sokolovmy/HLC/README.md

# HLC Home Light Controller 

v0.4 HW & FW
