sokolovmy/HLC/HW/COMMON_BOM.xlsx

Sheet: main_board
Reference | Quantity | Value | Footprint | LCSC Part | P/N | Arrow Part Number | %
BT1 | 1 | 3v | Battery:BatteryHolder_Keystone_106_1x20mm
C1 | 1 | 100pf | Capacitor_SMD:C_0402_1005Metric | C696853
C10 C11 C12 C13 C14 C15 C16 C17 C21 | 9 | 0,1uF | Capacitor_SMD:C_0402_1005Metric | C83056
C18 | 1 | 22nf | Capacitor_SMD:C_0402_1005Metric | C466237
C19 | 1 | 10uF | Capacitor_SMD:C_0805_2012Metric | C337995
C2 C3 C4 C5 C6 C23 C24 C25 C26 C27 C28 C29 C30 C31 C32 C33 C34 C35 C36 C37 C38 C39 C40 C41 C42 C43 C44 C45 C46 C47 C48 C49 C50 C51 C52 C53 C54 C55 | 38 | 100nf | Capacitor_SMD:C_0402_1005Metric | C83056
C20 | 1 | 22uF/25v | Capacitor_SMD:C_0805_2012Metric_Pad1.18x1.45mm_HandSolder | C45783
C22 | 1 | 22uF | Capacitor_SMD:C_0805_2012Metric | C45783
C8 C9 | 2 | 1uF | Capacitor_SMD:C_0603_1608Metric | C1592
D24 | 1 | 10V/0.5W | Diode_SMD:D_MiniMELF | C707201
D4 D5 D8 D9 D10 D11 D12 D13 D14 D15 D16 D17 D18 D19 D20 D21 D22 D23 | 18 | PESD3v3S2UT | Package_TO_SOT_SMD:SOT-23 | C84276
D6 D7 D25 | 3 | SS14 | Diode_SMD:D_SMA_Handsoldering | C509048
F1 | 1 | 0.4A | Fuse:Fuse_1812_4532Metric_Pad1.30x3.40mm_HandSolder | C369179
J1 | 1 | Program | holse:Program_Crossboard
J11 | 1 | cross | holse:Crossboard
J2 | 1 | Conn_01x20_Male | holse:IDC-Header_2x10_P2.54mm_Vertical
J3 | 1 | Conn_01x20_Male | holse:IDC-Header_2x10_P2.54mm_Horizontal
J8 | 1 | Input Buttons | holse:IDC-Header_2x17_P2.54mm_Horizontal
J9 | 1 | Power_12V | holse:SolderWire-0.5sqmm_1x02_P4.6mm_D0.9mm_OD2.1mm
L1 | 1 | 10uH | Inductor_SMD:L_Bourns-SRN6028 | C326329
PS1 | 1 | AP5100WG-7 | holse:SOT95P285X140-6N | C114647 |  | AP5100WG-7
Q1 | 1 | FDS4435BZ | Package_SO:SOIC-8_3.9x4.9mm_P1.27mm | C23931
R10 R12 R15 R16 | 4 | 22 | Resistor_SMD:R_0603_1608Metric | C96423
R11 R13 R17 R18 R19 R20 R21 R22 R23 R24 R25 R26 R27 R30 R31 | 15 | 100k | Resistor_SMD:R_0603_1608Metric | C177329
R14 | 1 | 1k | Resistor_SMD:R_0603_1608Metric | C112433
R28 | 1 | 49.9k | Resistor_SMD:R_0603_1608Metric | C705862 |  |  | 0.1
R29 | 1 | 16.2k | Resistor_SMD:R_0603_1608Metric | C667056 |  |  | 0.1
RN1 RN2 RN5 RN6 RN9 RN10 RN13 RN14 | 8 | 1k | holse:R_Array_Convex_4x0603 | C153136
RN3 RN4 RN7 RN8 RN11 RN12 RN15 RN16 | 8 | 10k | holse:R_Array_Convex_4x0603 | C164037
U1 | 1 | STM32F103CBTx | Package_QFP:LQFP-48_7x7mm_P0.5mm | C8304
U10 U11 U12 U13 | 4 | 74HC165 | Package_SO:SOIC-16_4.55x10.3mm_P1.27mm | C7334
U14 | 1 | M95256-WMN6P | Package_SO:SOIC-8_3.9x4.9mm_P1.27mm | C222231
U2 U4 U6 U8 | 4 | 74HC595 | Package_SO:SOIC-16_4.55x10.3mm_P1.27mm | C5947
U3 U5 U7 U9 | 4 | ULN2803A | Package_SO:SOIC-18W_7.5x11.6mm_P1.27mm | C9683
Y1 | 1 | 8mhz | Crystal:Resonator_SMD_muRata_CSTxExxV-3Pin_3.0x1.1mm | C22549 | CSTCE8M00G52-R0 MuraTA

Sheet: interface
Reference | Quantity | Value | Footprint | Datasheet | LCSC Part
C1 C2 | 2 | 1uF | Capacitor_SMD:C_0603_1608Metric | ~ | C1592
C3 C4 C5 C6 C7 | 5 | 100nf | Capacitor_SMD:C_0402_1005Metric | ~ | C83056
D1 D2 D3 D4 D5 D6 D7 D8 D9 D10 D11 D12 D13 D14 D15 D16 D17 D18 D19 D20 D21 D22 D23 D24 D25 D26 D27 D28 D29 D30 D31 D32 | 32 | LED | holse:LED_0805_2012Metric_Castellated | ~ | C205441
D33 | 1 | LEDG | holse:LED_0805_2012Metric_Castellated |  | C205442
D34 | 1 | LEDR | holse:LED_0805_2012Metric_Castellated |  | C130114
J1 | 1 | Program_M_Board | holse:Program_Crossboard | ~
J2 | 1 | Program | holse:PinHeader_1x06_P2.54mm_Vertical | ~
J3 | 1 | Crossboard | holse:Crossboard | ~
J4 | 1 | USB_B_Micro | holse:USB_Micro-B_Molex-105133-0001 | ~ | C168716
R1 R2 R3 R6 | 4 | 100k | Resistor_SMD:R_0603_1608Metric | ~ | C177329
R4 R5 | 2 | 10k | Resistor_SMD:R_0603_1608Metric | ~ | C99198
R7 | 1 | 100 | Resistor_SMD:R_0603_1608Metric | ~ | C86983
R8 | 1 | 1.5k | Resistor_SMD:R_0603_1608Metric | ~ | C25989
R9 R10 | 2 | 22 | Resistor_SMD:R_0603_1608Metric | ~ | C96423
RN1 RN2 RN3 RN4 RN5 RN6 RN7 RN8 | 8 | 10k | holse:R_Array_Convex_4x0603 | ~ | C164037
SW1 | 1 | BTN | Button_Switch_SMD:SW_SPST_EVPBF | ~ | C620321
U1 U2 U3 U4 | 4 | 74HC595 | Package_SO:SOIC-16_4.55x10.3mm_P1.27mm | http://www.ti.com/lit/ds/symlink/sn74hc595.pdf | C5947
U5 | 1 | USBLC6-2SC6 | Package_TO_SOT_SMD:SOT-23-6 | https://www.st.com/resource/en/datasheet/usblc6-2.pdf | C7519

Sheet: relay
Reference | Quantity | Value | Footprint | Datasheet
J1 | 1 | To_Main_Board | holse:IDC-Header_2x10_P2.54mm_Vertical | ~
J12 | 1 | To_Main_Board | holse:IDC-Header_2x10_P2.54mm_Horizontal | ~
J2 | 1 | Main Board Power | holse:SolderWire-0.5sqmm_1x02_P4.6mm_D0.9mm_OD2.1mm | ~
J3 | 1 | Power | Connector_Phoenix_MC_HighVoltage:PhoenixContact_MC_1,5_2-G-5.08_1x02_P5.08mm_Horizontal | ~
J4 J5 J6 J7 J8 J9 J10 J11 | 8 | Relay out | holse:PhoenixContact_MC_1,5_3-G-5.08_1x03_P5.08mm_Horizontal | ~
K1 K2 K3 K4 K5 K6 K7 K8 K9 K10 K11 K12 K13 K14 K15 K16 | 16 | RT334012 | holse:Relay_DPST_Schrack-RT2-FormA_RM5mm

Sheet: Common
Reference | Quantity | Value | Footprint | LCSC Part # | LCSC Price | terraelectronica part # | terraelectronica price
Capasitors
 | 1 | 100pf | C_0402 | C696853 |  | 1910184 | 0.10 ₽ | 0.10 ₽
 | 1 | 22nf | C_0402 | C466237 |  | 866778 | 0.21 ₽ | 0.21 ₽
 | 1 | 10uF | C_0805 | C337995 |  | 442193 | 0.79 ₽ | 0.79 ₽
 | 52 | 100nf | C_0402 | C83056 |  | 337966(Yageo) 863217(samsung) | 0.12 ₽ | 6.24 ₽
 | 2 | 22uF/25v | C_0805 | C45783 |  | 1489879 | 2.50 ₽ | 5.00 ₽
 | 4 | 1uF | C_0603 | C1592 |  | 863285 | 0.30 ₽ | 1.20 ₽
Resistors
 | 6 | 22 | R_0603 | C96423 |  | 2782143 | 0.04 ₽ | 0.24 ₽
 | 19 | 100k | R_0603 | C177329 |  | 533322 | 0.06 ₽ | 1.14 ₽
 | 1 | 1k | R_0603 | C112433 |  | 1079152 | 0.05 ₽ | 0.05 ₽
 | 1 | 49.9k | R_0603 | C705862 |  | 819775 | 0.13 ₽ | 0.13 ₽
 | 1 | 16.2k | R_0603 | C667056 |  | 568313 | 0.10 ₽ | 0.10 ₽
 | 1 | 100 | R_0603 | C86983 |  | 431790 | 0.06 ₽ | 0.06 ₽
 | 1 | 1.5k | R_0603 | C25989 |  | 327599 | 0.08 ₽ | 0.08 ₽
 | 8 | 1k | R_Array_Convex_4x0603 | C153136 |  | 980470 (Под заказ 3недели) | 1.84 ₽ | 14.72 ₽
 | 16 | 10k | R_Array_Convex_4x0603 | C164037 |  | 1081045 | 1.10 ₽ | 17.60 ₽
Others
LED blue | 32 | LED | holse:LED_0805_2012Metric_Castellated | C205441 |  | 881469 | 2.80 ₽ | 89.60 ₽
LED Green | 1 | LEDG | holse:LED_0805_2012Metric_Castellated | C205442 |  | 600843 | 1.90 ₽ | 1.90 ₽
LED RED | 1 | LEDR | holse:LED_0805_2012Metric_Castellated | C130114 |  | 601116 | 1.90 ₽ | 1.90 ₽
Zenner | 1 | 10V/0.5W | D_MiniMELF | C707201 |  | 38449(MiniMelf) — 1.2р / 305160(SOD 323) — 0.9р | 1.20 ₽ | 1.20 ₽
TVS 2 3.3v | 18 | PESD3v3S2UT | SOT-23 | C84276 |  | 289331 | 3.10 ₽ | 55.80 ₽
USB TVS | 1 | USBLC6-2SC6 | Package_TO_SOT_SMD:SOT-23-6 | C7519 |  | 244787 | 4.30 ₽ | 4.30 ₽
Schot Diode | 3 | SS14 | DD_SMA | C509048 |  | 1006032 | 1.20 ₽ | 3.60 ₽
Fuse | 1 | 0.4A | Fuse:Fuse_1812_4532Metric_Pad1.30x3.40mm_HandSolder (5mm x 3mm) | C369179 |  | 1126559 (500ма) | 6.30 ₽ | 6.30 ₽
CSTCE8M00G52-R0 MuraTA | 1 | 8mhz | Resonator_SMD_muRata_CSTxExxV-3Pin_3.0x1.1mm | C22549 |  | 183831 | 13.20 ₽ | 13.20 ₽
Inductor SMD | 1 | 10uH | Inductor_SMD:L_Bourns-SRN6028 (6mm x 6mm) | C326329 |  | 1043884 (4.8x4.8mm) | 26.90 ₽ | 26.90 ₽
transistor | 1 | FDS4435BZ | SOIC-8_3.9x4.9mm_P1.27mm | C23931 |  | 343027 | 14.70 ₽ | 14.70 ₽
Button Switch SMD (6x6mm) | 1 | BTN | Button_Switch_SMD:SW_SPST_EVPBF | C620321 |  | 893275 | 13.30 ₽ | 13.30 ₽
Micros
 | 1 | AP5100WG-7 | SOT95P285X140-6N (SOT23-6) | C114647 |  | AP5100WG-7 (Под заказ 16 дней) при покупке от 8ми шт. (от 16 38р, от трех шт 69р) | 48.57 ₽ | 48.57 ₽
 | 1 | STM32F103CBTx | LQFP-48_7x7mm_P0.5mm | C8304 |  | под заказ под нереальные цены от 1000р Chipdip 340р | 340.00 ₽ | 340.00 ₽
 | 4 | 74HC165 | SOIC-16_4.55x10.3mm_P1.27mm | C7334 |  | 51304 | 7.80 ₽ | 31.20 ₽
 | 1 | M95256-WMN6P | SOIC-8_3.9x4.9mm_P1.27mm | C222231 |  | 337665 | 72.73 ₽ | 72.73 ₽
 | 8 | 74HC595 | SOIC-16_4.55x10.3mm_P1.27mm | C5947 |  | 242487 | 8.00 ₽ | 64.00 ₽
 | 4 | ULN2803A | SOIC-18W_7.5x11.6mm_P1.27mm | C9683 |  | 159173 | 28.10 ₽ | 112.40 ₽
Connectors
 | 2 | Conn_01x20_Male | IDC-Header_2x10_P2.54mm_Vertical |  |  | цены нереальные | 20.00 ₽ | 40.00 ₽
 | 1 | Conn_01x20_Male | IDC-Header_2x10_P2.54mm_Horizontal |  |  |  | 20.00 ₽ | 20.00 ₽
 | 1 | Input Buttons | IDC-Header_2x17_P2.54mm_Horizontal |  |  |  | 40.00 ₽ | 40.00 ₽
 | 1 | USB_B_Micro | holse:USB_Micro-B_Molex-105133-0001 | C168716 |  | 3242766 | 56.50 ₽ | 56.50 ₽
5.08x2 HighVoltage | 1 | Power | PhoenixContact_MC_1,5_2-G-5.08_1x02_P5.08mm_Horizontal
5.08x3 HighVoltage | 8 | Relay out | PhoenixContact_MC_1,5_3-G-5.08_1x03_P5.08mm_Horizontal
Relays | 16 | RT334012 | holse:Relay_DPST_Schrack-RT2-FormA_RM5mm
 | 4 | IDC20 на шлейф |  |  |  | 822988 | 5.00 ₽ | 20.00 ₽
 |  |  |  |  |  |  |  | 1125.76 ₽
