sokolovmy/HLC/HW/relay_board.kicad_pcb

## KiCad design HW/relay_board.kicad_pcb (2022-03-30)

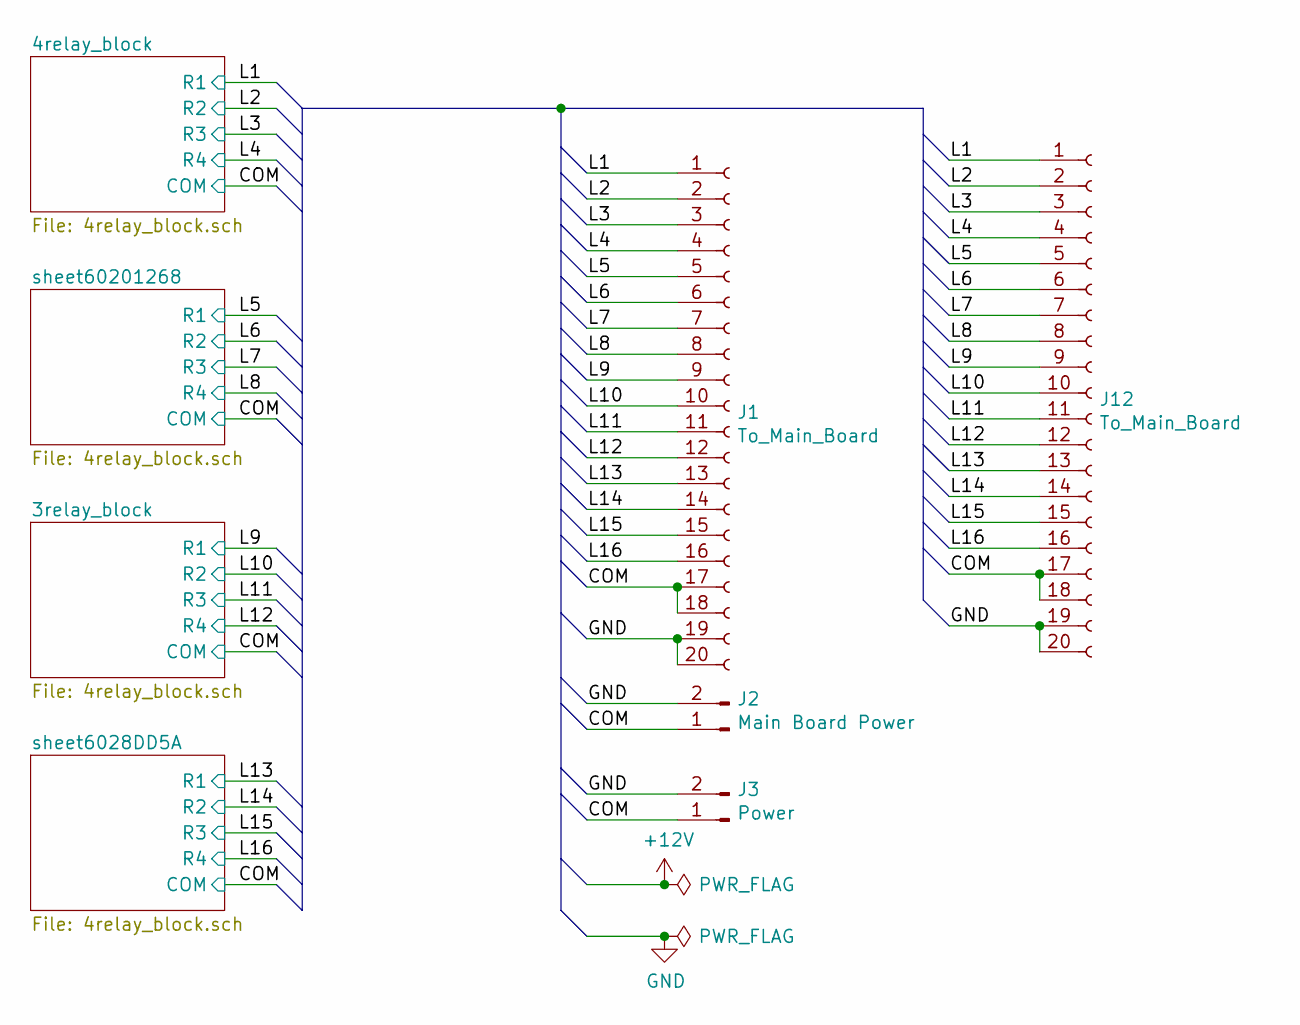
[picture p1: schematic relay_board.sch]

Parts:
J1: To_Main_Board; IDC-Header_2x10_P2.54mm_Vertical
J2: Main Board Power; SolderWire-0.5sqmm_1x02_P4.6mm_D0.9mm_OD2.1mm
J3: Power; PhoenixContact_MC_1,5_2-G-5.08_1x02_P5.08mm_Horizontal
J12: To_Main_Board; IDC-Header_2x10_P2.54mm_Horizontal

Connections:
/COM: J1.17, J1.18, J2.1, J3.1, J12.17, J12.18; also elsewhere on the board
/L1: J1.1, J12.1; also elsewhere on the board
/L2: J1.2, J12.2; also elsewhere on the board
/L3: J1.3, J12.3; also elsewhere on the board
/L4: J1.4, J12.4; also elsewhere on the board
/L5: J1.5, J12.5; also elsewhere on the board
/L6: J1.6, J12.6; also elsewhere on the board
/L7: J1.7, J12.7; also elsewhere on the board
/L8: J1.8, J12.8; also elsewhere on the board
/L9: J1.9, J12.9; also elsewhere on the board
/L10: J1.10, J12.10; also elsewhere on the board
/L11: J1.11, J12.11; also elsewhere on the board
/L12: J1.12, J12.12; also elsewhere on the board
/L13: J1.13, J12.13; also elsewhere on the board
/L14: J1.14, J12.14; also elsewhere on the board
/L15: J1.15, J12.15; also elsewhere on the board
/L16: J1.16, J12.16; also elsewhere on the board
GND: J1.19, J1.20, J2.2, J3.2, J12.19, J12.20

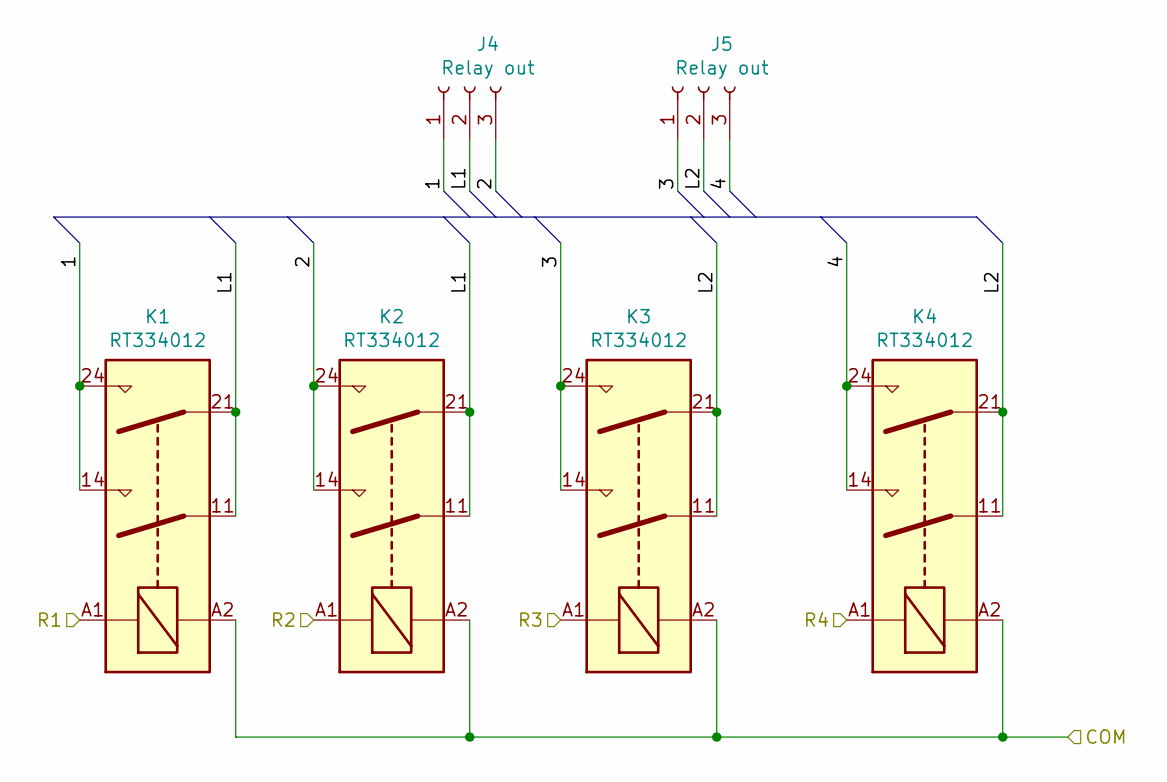
[picture p2: schematic 4relay_block.sch]

Parts:
J4, J5: Relay out; PhoenixContact_MC_1,5_3-G-5.08_1x03_P5.08mm_Horizontal
K1, K2, K3, K4: RT334012; Relay_DPST_Schrack-RT2-FormA_RM5mm

Connections:
/4relay_block/1: J4.1, K1.14, K1.24
/4relay_block/2: J4.3, K2.14, K2.24
/4relay_block/3: J5.1, K3.14, K3.24
/4relay_block/4: J5.3, K4.14, K4.24
/4relay_block/L1: J4.2, K1.11, K1.21, K2.11, K2.21
/4relay_block/L2: J5.2, K3.11, K3.21, K4.11, K4.21
/COM: K1.A2, K2.A2, K3.A2, K4.A2; also elsewhere on the board
/L1: K1.A1; also elsewhere on the board
/L2: K2.A1; also elsewhere on the board
/L3: K3.A1; also elsewhere on the board
/L4: K4.A1; also elsewhere on the board

Parts of its further copies:
J6, J7, J8, J9, J10, J11: Relay out; PhoenixContact_MC_1,5_3-G-5.08_1x03_P5.08mm_Horizontal
K5, K6, K7, K8, K9, K10, K11, K12, K13, K14, K15, K16: RT334012; Relay_DPST_Schrack-RT2-FormA_RM5mm

Connections of its further copies:
/3relay_block/1: J8.1, K9.14, K9.24
/3relay_block/2: J8.3, K10.14, K10.24
/3relay_block/3: J9.1, K11.14, K11.24
/3relay_block/4: J9.3, K12.14, K12.24
/3relay_block/L1: J8.2, K9.11, K9.21, K10.11, K10.21
/3relay_block/L2: J9.2, K11.11, K11.21, K12.11, K12.21
/COM: K5.A2, K6.A2, K7.A2, K8.A2, K9.A2, K10.A2, K11.A2, K12.A2, K13.A2, K14.A2, K15.A2, K16.A2; also elsewhere on the board
/L5: K5.A1; also elsewhere on the board
/L6: K6.A1; also elsewhere on the board
/L7: K7.A1; also elsewhere on the board
/L8: K8.A1; also elsewhere on the board
/L9: K9.A1; also elsewhere on the board
/L10: K10.A1; also elsewhere on the board
/L11: K11.A1; also elsewhere on the board
/L12: K12.A1; also elsewhere on the board
/L13: K13.A1; also elsewhere on the board
/L14: K14.A1; also elsewhere on the board
/L15: K15.A1; also elsewhere on the board
/L16: K16.A1; also elsewhere on the board
/sheet6028DD5A/1: J10.1, K13.14, K13.24
/sheet6028DD5A/2: J10.3, K14.14, K14.24
/sheet6028DD5A/3: J11.1, K15.14, K15.24
/sheet6028DD5A/4: J11.3, K16.14, K16.24
/sheet6028DD5A/L1: J10.2, K13.11, K13.21, K14.11, K14.21
/sheet6028DD5A/L2: J11.2, K15.11, K15.21, K16.11, K16.21
/sheet60201268/1: J6.1, K5.14, K5.24
/sheet60201268/2: J6.3, K6.14, K6.24
/sheet60201268/3: J7.1, K7.14, K7.24
/sheet60201268/4: J7.3, K8.14, K8.24
/sheet60201268/L1: J6.2, K5.11, K5.21, K6.11, K6.21
/sheet60201268/L2: J7.2, K7.11, K7.21, K8.11, K8.21

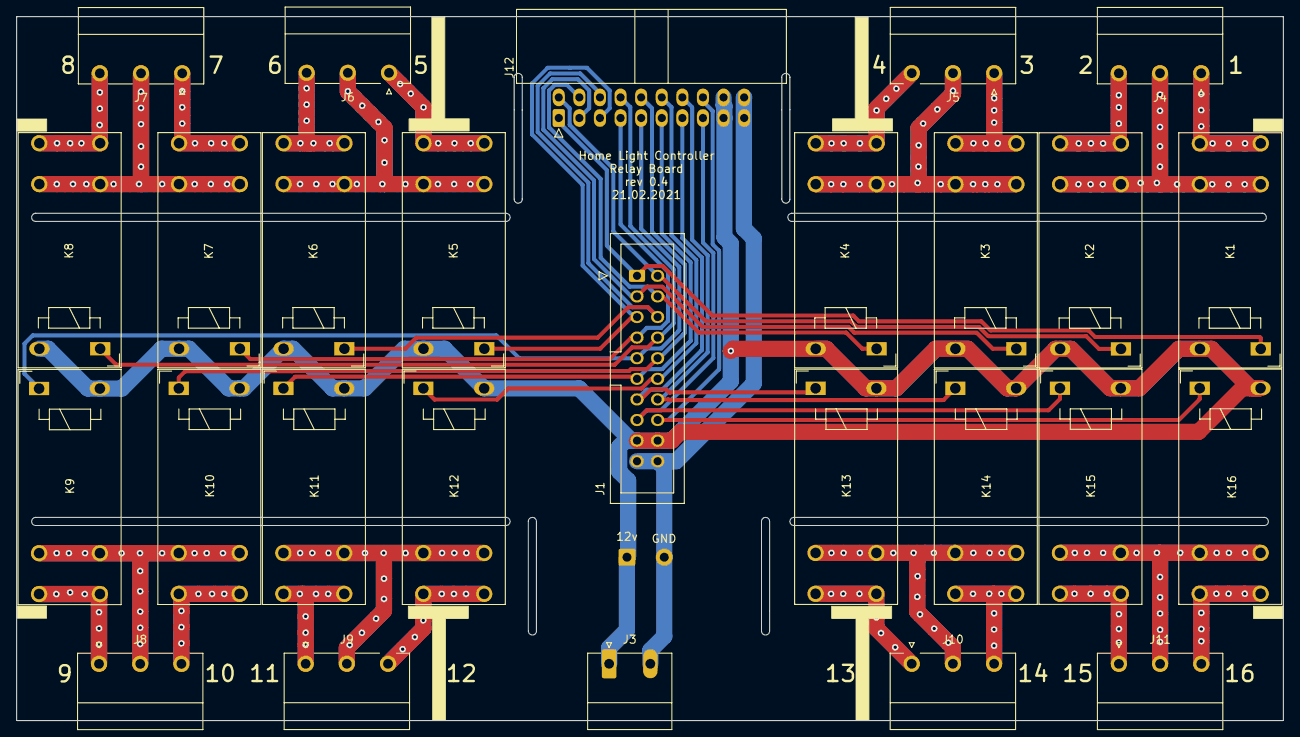
[picture p3: board relay_board.kicad_pcb from above]

Board: 2 copper layers, 156.2 x 86.8 mm, 28 parts (0 on the bottom side), 42 nets.
