sokolovmy/HLC/HW/main_board.kicad_pcb

## KiCad design HW/main_board.kicad_pcb (2022-03-30)

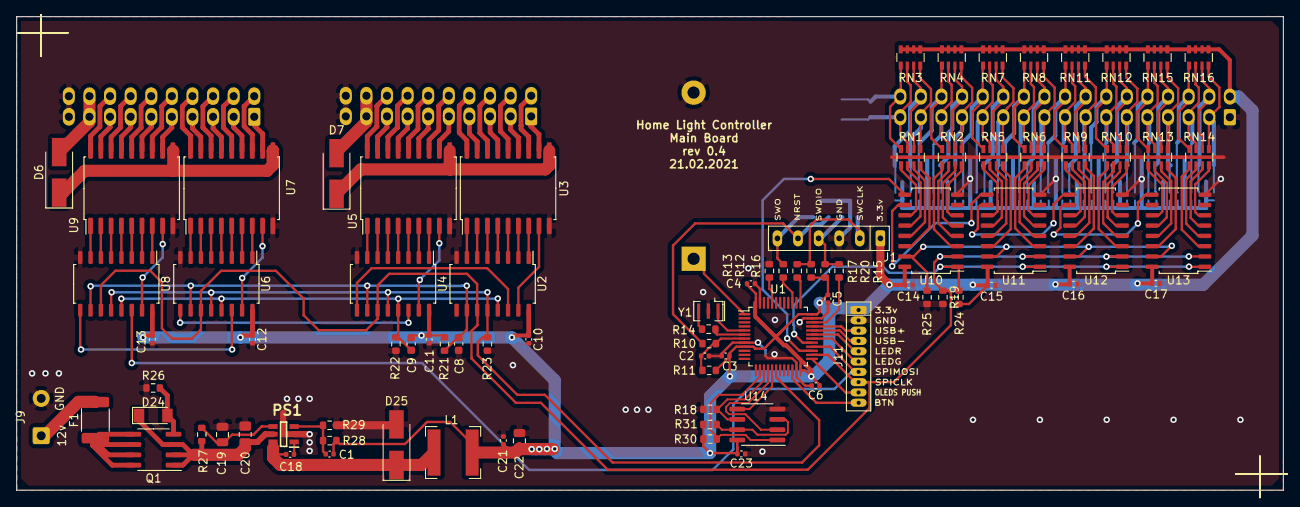
[picture p4: board main_board.kicad_pcb from above]

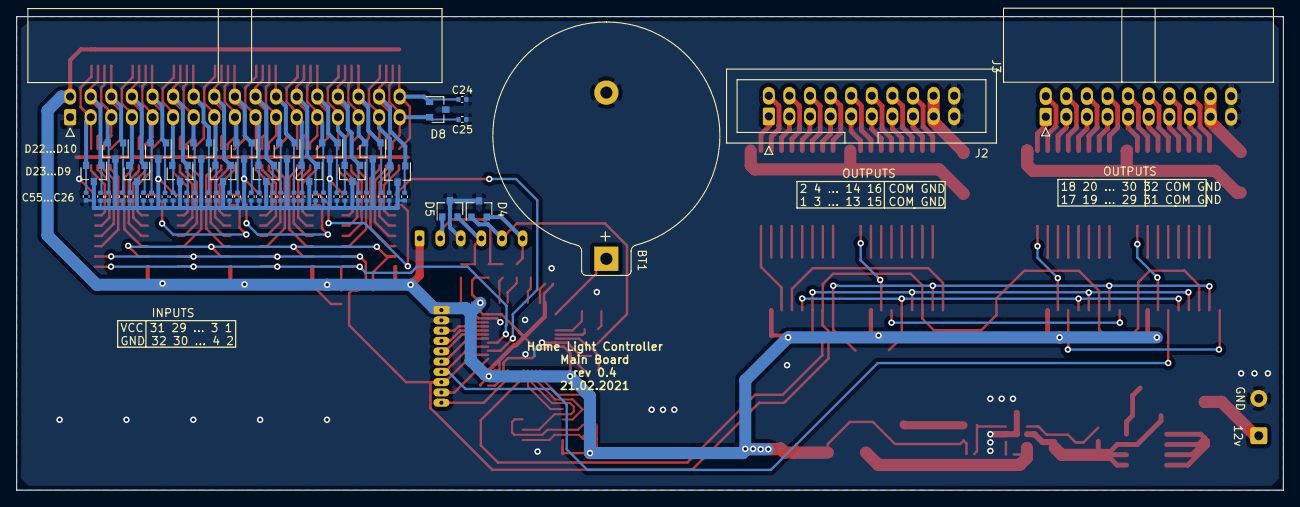
[picture p5: board main_board.kicad_pcb from below]

Board: 2 copper layers, 156.2 x 58.4 mm, 140 parts (55 on the bottom side), 180 nets.

Parts:
BT1: 3v; BatteryHolder_Keystone_106_1x20mm
C1: 100pf; C_0402_1005Metric
C2, C3, C4, C5, C6, C24, C25, C26, C27, C28, C29, C30, C31, C32, C33, C34, C35, C36, C37, C38, C39, C40, C41, C42, C43, C44, C45, C46, C47, C48, C49, C50, C51, C52, C53, C54, C55: 0.1uf; C_0402_1005Metric
C8, C9: 1uF; C_0603_1608Metric
C10, C11, C12, C13, C14, C15, C16, C17, C21: 0,1uF; C_0402_1005Metric
C18: 22nf; C_0402_1005Metric
C19: 10uF; C_0805_2012Metric
C20: 22uF/25v; C_0805_2012Metric_Pad1.18x1.45mm_HandSolder
C22: 22uF; C_0805_2012Metric
C23: 0,1; C_0402_1005Metric
D4, D5, D8, D9, D10, D11, D12, D13, D14, D15, D16, D17, D18, D19, D20, D21, D22, D23: PESD3v3S2UT; SOT-23
D6, D7, D25: SS14; D_SMA_Handsoldering
D24: 10V/0.5W; D_MiniMELF
F1: 0.4A; Fuse_1812_4532Metric_Pad1.30x3.40mm_HandSolder
J1: Program; Program_Crossboard
J2: Conn_01x20_Male; IDC-Header_2x10_P2.54mm_Vertical
J3: Conn_01x20_Male; IDC-Header_2x10_P2.54mm_Horizontal
J8: Input Buttons; IDC-Header_2x17_P2.54mm_Horizontal
J9: Power_12V; SolderWire-0.5sqmm_1x02_P4.6mm_D0.9mm_OD2.1mm
J11: cross; Crossboard
L1: 10uH; L_Bourns-SRN6028
PS1: AP5100WG-7; SOT95P285X140-6N
Q1: FDS4435BZ; SOIC-8_3.9x4.9mm_P1.27mm
R10, R12, R15, R16: 22; R_0603_1608Metric
R11, R13, R17, R18, R19, R20, R21, R22, R23, R24, R25, R26, R27, R30, R31: 100k; R_0603_1608Metric
R14: 1k; R_0603_1608Metric
R28: 49.9k; R_0603_1608Metric
R29: 16.2k; R_0603_1608Metric
RN1, RN2, RN5, RN6, RN9, RN10, RN13, RN14: 1k; R_Array_Convex_4x0603
RN3, RN4, RN7, RN8, RN11, RN12, RN15, RN16: 10k; R_Array_Convex_4x0603
U1: STM32F103CBTx; LQFP-48_7x7mm_P0.5mm
U2, U4, U6, U8: 74HC595; SOIC-16_4.55x10.3mm_P1.27mm
U3, U5, U7, U9: ULN2803A; SOIC-18W_7.5x11.6mm_P1.27mm
U10, U11, U12, U13: 74HC165; SOIC-16_4.55x10.3mm_P1.27mm
U14: M95256-WMN6P; SOIC-8_3.9x4.9mm_P1.27mm
Y1: 8mhz; Resonator_SMD_muRata_CSTxExxV-3Pin_3.0x1.1mm

Connections:
/BOOT0: R13.2, U1.44
/Inputs/Inputs8bit1/Cascade_Serial: U10.10, U11.9
/Inputs/Inputs8bit1/I1: C24.1, D8.1, J8.34, RN1.8, RN3.5
/Inputs/Inputs8bit1/I2: C25.1, D8.2, J8.33, RN1.7, RN3.6
/Inputs/Inputs8bit1/I3: C26.1, D9.1, J8.32, RN1.6, RN3.7
/Inputs/Inputs8bit1/I4: C27.1, D9.2, J8.31, RN1.5, RN3.8
/Inputs/Inputs8bit1/I5: C28.1, D10.1, J8.30, RN2.8, RN4.5
/Inputs/Inputs8bit1/I6: C29.1, D10.2, J8.29, RN2.7, RN4.6
/Inputs/Inputs8bit1/I7: C30.1, D11.1, J8.28, RN2.6, RN4.7
/Inputs/Inputs8bit1/I8: C31.1, D11.2, J8.27, RN2.5, RN4.8
/Inputs/Inputs8bit2/Cascade_Serial: U11.10, U12.9
/Inputs/Inputs8bit2/I1: C32.1, D12.1, J8.26, RN5.8, RN7.5
/Inputs/Inputs8bit2/I2: C33.1, D12.2, J8.25, RN5.7, RN7.6
/Inputs/Inputs8bit2/I3: C34.1, D13.1, J8.24, RN5.6, RN7.7
/Inputs/Inputs8bit2/I4: C35.1, D13.2, J8.23, RN5.5, RN7.8
/Inputs/Inputs8bit2/I5: C36.1, D14.1, J8.22, RN6.8, RN8.5
/Inputs/Inputs8bit2/I6: C37.1, D14.2, J8.21, RN6.7, RN8.6
/Inputs/Inputs8bit2/I7: C38.1, D15.1, J8.20, RN6.6, RN8.7
/Inputs/Inputs8bit2/I8: C39.1, D15.2, J8.19, RN6.5, RN8.8
/Inputs/Inputs8bit3/Cascade_Serial: U12.10, U13.9
/Inputs/Inputs8bit3/I1: C40.1, D16.1, J8.18, RN9.8, RN11.5
/Inputs/Inputs8bit3/I2: C41.1, D16.2, J8.17, RN9.7, RN11.6
/Inputs/Inputs8bit3/I3: C42.1, D17.1, J8.16, RN9.6, RN11.7
/Inputs/Inputs8bit3/I4: C43.1, D17.2, J8.15, RN9.5, RN11.8
/Inputs/Inputs8bit3/I5: C44.1, D18.1, J8.14, RN10.8, RN12.5
/Inputs/Inputs8bit3/I6: C45.1, D18.2, J8.13, RN10.7, RN12.6
/Inputs/Inputs8bit3/I7: C46.1, D19.1, J8.12, RN10.6, RN12.7
/Inputs/Inputs8bit3/I8: C47.1, D19.2, J8.11, RN10.5, RN12.8
/Inputs/Inputs8bit4/I1: C48.1, D20.1, J8.10, RN13.8, RN15.5
/Inputs/Inputs8bit4/I2: C49.1, D20.2, J8.9, RN13.7, RN15.6
/Inputs/Inputs8bit4/I3: C50.1, D21.1, J8.8, RN13.6, RN15.7
/Inputs/Inputs8bit4/I4: C51.1, D21.2, J8.7, RN13.5, RN15.8
/Inputs/Inputs8bit4/I5: C52.1, D22.1, J8.6, RN14.8, RN16.5
/Inputs/Inputs8bit4/I6: C53.1, D22.2, J8.5, RN14.7, RN16.6
/Inputs/Inputs8bit4/I7: C54.1, D23.1, J8.4, RN14.6, RN16.7
/Inputs/Inputs8bit4/I8: C55.1, D23.2, J8.3, RN14.5, RN16.8
/Inputs/in_CLK_Inhb: R25.1, U10.15, U11.15, U12.15, U13.15
/Outputs/OEnable: C9.2, R22.2, U2.13, U4.13, U6.13, U8.13
/Outputs/ONReg1: U2.14, U4.9
/Outputs/ONReg2: U4.14, U6.9
/Outputs/ONReg3: U6.14, U8.9
/Outputs/Outputs8bit/lo1: U2.15, U3.8
/Outputs/Outputs8bit/lo2: U2.1, U3.7
/Outputs/Outputs8bit/lo3: U2.2, U3.6
/Outputs/Outputs8bit/lo4: U2.3, U3.5
/Outputs/Outputs8bit/lo5: U2.4, U3.4
/Outputs/Outputs8bit/lo6: U2.5, U3.3
/Outputs/Outputs8bit/lo7: U2.6, U3.2
/Outputs/Outputs8bit/lo8: U2.7, U3.1
/Outputs/Reset: C8.1, R21.1, U2.10, U4.10, U6.10, U8.10
/Outputs/oa1: J2.1, U3.11
/Outputs/oa2: J2.2, U3.12
/Outputs/oa3: J2.3, U3.13
/Outputs/oa4: J2.4, U3.14
/Outputs/oa5: J2.5, U3.15
/Outputs/oa6: J2.6, U3.16
/Outputs/oa7: J2.7, U3.17
/Outputs/oa8: J2.8, U3.18
/Outputs/oa9: J2.9, U5.11
/Outputs/oa10: J2.10, U5.12
/Outputs/oa11: J2.11, U5.13
/Outputs/oa12: J2.12, U5.14
/Outputs/oa13: J2.13, U5.15
/Outputs/oa14: J2.14, U5.16
/Outputs/oa15: J2.15, U5.17
/Outputs/oa16: J2.16, U5.18
/Outputs/oa17: J3.1, U7.11
/Outputs/oa18: J3.2, U7.12
/Outputs/oa19: J3.3, U7.13
/Outputs/oa20: J3.4, U7.14
/Outputs/oa21: J3.5, U7.15
/Outputs/oa22: J3.6, U7.16
/Outputs/oa23: J3.7, U7.17
/Outputs/oa24: J3.8, U7.18
/Outputs/oa25: J3.9, U9.11
/Outputs/oa26: J3.10, U9.12
/Outputs/oa27: J3.11, U9.13
/Outputs/oa28: J3.12, U9.14
/Outputs/oa29: J3.13, U9.15
/Outputs/oa30: J3.14, U9.16
/Outputs/oa31: J3.15, U9.17
/Outputs/oa32: J3.16, U9.18
/Outputs/oaCOM: D7.1, U3.10, U5.10
/Outputs/oaCOM2: D6.1, U7.10, U9.10
/Outputs/sheet603D1D0F/lo1: U6.15, U7.8
/Outputs/sheet603D1D0F/lo2: U6.1, U7.7
/Outputs/sheet603D1D0F/lo3: U6.2, U7.6
/Outputs/sheet603D1D0F/lo4: U6.3, U7.5
/Outputs/sheet603D1D0F/lo5: U6.4, U7.4
/Outputs/sheet603D1D0F/lo6: U6.5, U7.3
/Outputs/sheet603D1D0F/lo7: U6.6, U7.2
/Outputs/sheet603D1D0F/lo8: U6.7, U7.1
/Outputs/sheet6038A325/lo1: U4.15, U5.8
/Outputs/sheet6038A325/lo2: U4.1, U5.7
/Outputs/sheet6038A325/lo3: U4.2, U5.6
/Outputs/sheet6038A325/lo4: U4.3, U5.5
/Outputs/sheet6038A325/lo5: U4.4, U5.4
/Outputs/sheet6038A325/lo6: U4.5, U5.3
/Outputs/sheet6038A325/lo7: U4.6, U5.2
/Outputs/sheet6038A325/lo8: U4.7, U5.1
/Outputs/sheet60400210/lo1: U8.15, U9.8
/Outputs/sheet60400210/lo2: U8.1, U9.7
/Outputs/sheet60400210/lo3: U8.2, U9.6
/Outputs/sheet60400210/lo4: U8.3, U9.5
/Outputs/sheet60400210/lo5: U8.4, U9.4
/Outputs/sheet60400210/lo6: U8.5, U9.3
/Outputs/sheet60400210/lo7: U8.6, U9.2
/Outputs/sheet60400210/lo8: U8.7, U9.1
BTN: J11.10, U1.22
EEPROM_SELECT: R30.2, U1.14, U14.1
GND: BT1.2, C2.2, C3.2, C4.2, C5.2, C6.2, C8.2, C10.2, C11.2, C12.2, C13.2, C14.2, C15.2, C16.2, C17.2, C19.2, C20.1, C21.2, C22.2, C23.1, C24.2, C25.2, C26.2, C27.2, C28.2, C29.2, C30.2, C31.2, C32.2, C33.2, C34.2, C35.2, C36.2, C37.2, C38.2, C39.2, C40.2, C41.2, C42.2, C43.2, C44.2, C45.2, C46.2, C47.2, C48.2, C49.2, C50.2, C51.2, C52.2, C53.2, C54.2, C55.2, D4.3, D5.3, D8.3, D9.3, D10.3, D11.3, D12.3, D13.3, D14.3, D15.3, D16.3, D17.3, D18.3, D19.3, D20.3, D21.3, D22.3, D23.3, D25.2, J1.3, J2.19, J2.20, J3.19, J3.20, J8.1, J9.2, J11.2, PS1.2, R13.1, R18.2, R19.2, R22.1, R23.1, R25.2, R26.2, R29.2, U1.8, U1.23, U1.35, U1.47, U2.8, U3.9, U4.8, U5.9, U6.8, U7.9, U8.8, U9.9, U10.8, U11.8, U12.8, U13.8, U14.4, Y1.2
IN_CLK: J11.8, R19.1, U1.26, U2.11, U4.11, U6.11, U8.11, U10.2, U11.2, U12.2, U13.2
IN_Load: R24.1, U1.29, U10.1, U11.1, U12.1, U13.1
IN_Serial: U1.27, U10.9
LED_GREEN: J11.6, U1.30
LED_RED: J11.5, U1.31
NRST: D4.1, J1.5, R10.1
unnamed: BT1.1, U1.1
unnamed: C1.2, PS1.3, R28.2, R29.1
unnamed: C2.1, R10.2, R11.1, U1.7
unnamed: C18.1, D25.1, L1.1, PS1.6
unnamed: C18.2, PS1.1
unnamed: C19.1, PS1.4, R27.2
unnamed: C20.2, D24.1, PS1.5, Q1.1, Q1.2, Q1.3, R27.1
unnamed: D6.2, J3.17, J3.18
unnamed: D7.2, J2.17, J2.18
unnamed: D24.2, Q1.4, R26.1
unnamed: F1.1, Q1.5, Q1.6, Q1.7, Q1.8
unnamed: F1.2, J9.1
unnamed: R12.1, U1.39
unnamed: R14.1, Y1.3
unnamed: R14.2, U1.6
unnamed: R15.1, U1.34
unnamed: R16.1, U1.37
unnamed: R31.2, U14.3, U14.7
unnamed: RN1.1, U10.11
unnamed: RN1.2, U10.12
unnamed: RN1.3, U10.13
unnamed: RN1.4, U10.14
unnamed: RN2.1, U10.3
unnamed: RN2.2, U10.4
unnamed: RN2.3, U10.5
unnamed: RN2.4, U10.6
unnamed: RN5.1, U11.11
unnamed: RN5.2, U11.12
unnamed: RN5.3, U11.13
unnamed: RN5.4, U11.14
unnamed: RN6.1, U11.3
unnamed: RN6.2, U11.4
unnamed: RN6.3, U11.5
unnamed: RN6.4, U11.6
unnamed: RN9.1, U12.11
unnamed: RN9.2, U12.12
unnamed: RN9.3, U12.13
unnamed: RN9.4, U12.14
unnamed: RN10.1, U12.3
unnamed: RN10.2, U12.4
unnamed: RN10.3, U12.5
unnamed: RN10.4, U12.6
unnamed: RN13.1, U13.11
unnamed: RN13.2, U13.12
unnamed: RN13.3, U13.13
unnamed: RN13.4, U13.14
unnamed: RN14.1, U13.3
unnamed: RN14.2, U13.4
unnamed: RN14.3, U13.5
unnamed: RN14.4, U13.6
unnamed: U1.5, Y1.1
OUT_LED_PUSH_DATA: J11.9, U1.25
OUT_Push_Data: R23.2, U1.18, U2.12, U4.12, U6.12, U8.12
OUT_Serial: J11.7, U1.28, U8.14
SPI1_CLK: R18.1, U1.15, U14.6
SPI1_MISO: U1.16, U14.2
SPI1_MOSI: U1.17, U14.5
SWCLK: D5.1, J1.2, R16.2, R17.2
SWDIO: D5.2, J1.4, R15.2, R20.2
SWO: D4.2, J1.6, R12.2
USB+: J11.3, U1.33
USB-: J11.4, U1.32
VCC: C1.1, C3.1, C4.1, C5.1, C6.1, C9.1, C10.1, C11.1, C12.1, C13.1, C14.1, C15.1, C16.1, C17.1, C21.1, C22.1, C23.2, J1.1, J8.2, J11.1, L1.2, R11.2, R17.1, R20.1, R21.2, R24.2, R28.1, R30.1, R31.1, RN3.1, RN3.2, RN3.3, RN3.4, RN4.1, RN4.2, RN4.3, RN4.4, RN7.1, RN7.2, RN7.3, RN7.4, RN8.1, RN8.2, RN8.3, RN8.4, RN11.1, RN11.2, RN11.3, RN11.4, RN12.1, RN12.2, RN12.3, RN12.4, RN15.1, RN15.2, RN15.3, RN15.4, RN16.1, RN16.2, RN16.3, RN16.4, U1.9, U1.24, U1.36, U1.48, U2.16, U4.16, U6.16, U8.16, U10.16, U11.16, U12.16, U13.16, U14.8
