sokolovmy/HLC/HW/interface_board.kicad_pcb

## KiCad design HW/interface_board.kicad_pcb (2022-03-30)

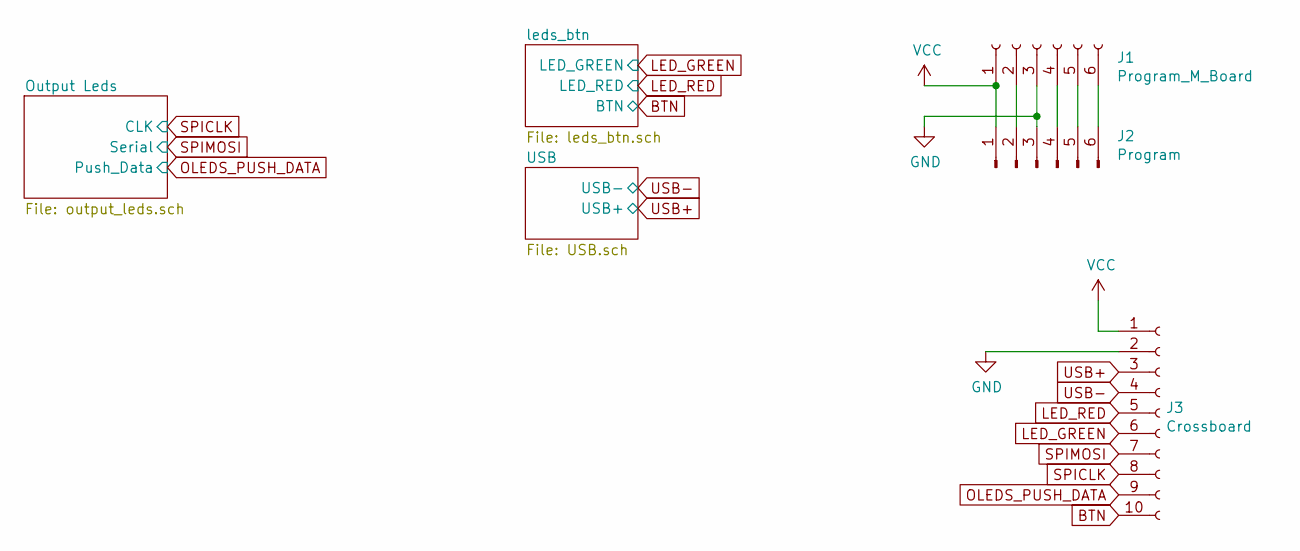
[picture p6: schematic interface_board.sch]

Parts:
J1: Program_M_Board; Program_Crossboard
J2: Program; PinHeader_1x06_P2.54mm_Vertical
J3: Crossboard

Connections:
BTN: J3.10; also elsewhere on the board
GND: J1.3, J2.3, J3.2; also elsewhere on the board
LED_GREEN: J3.6; also elsewhere on the board
LED_RED: J3.5; also elsewhere on the board
unnamed: J1.2, J2.2
unnamed: J1.4, J2.4
unnamed: J1.5, J2.5
unnamed: J1.6, J2.6
OLEDS_PUSH_DATA: J3.9; also elsewhere on the board
SPICLK: J3.8; also elsewhere on the board
SPIMOSI: J3.7; also elsewhere on the board
USB+: J3.3; also elsewhere on the board
USB-: J3.4; also elsewhere on the board
VCC: J1.1, J2.1, J3.1; also elsewhere on the board

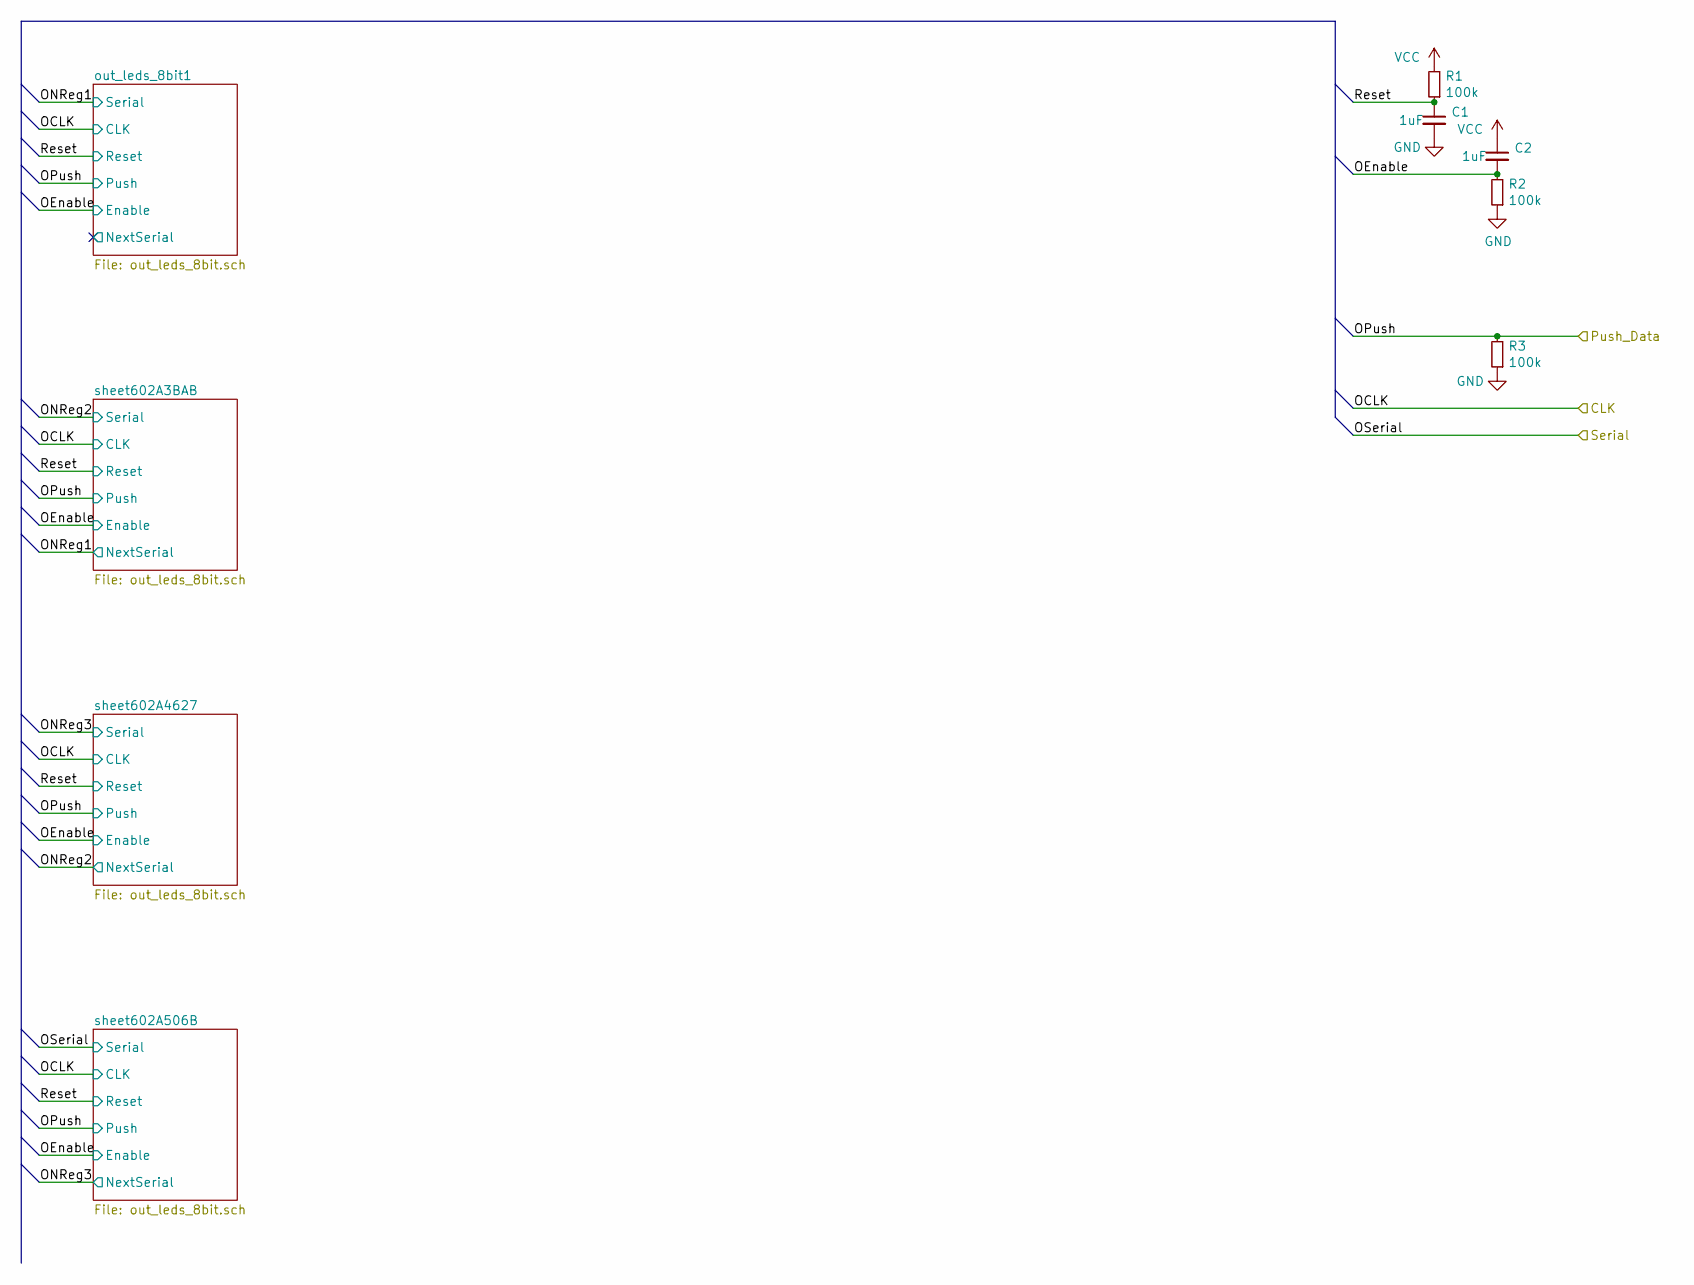
[picture p7: schematic output_leds.sch]

Parts:
C1: 1uF; C_0603_1608Metric; LCSC Part C1592
C2: 1uF; C_0603_1608Metric
R1, R2, R3: 100k; R_0603_1608Metric; LCSC Part C177329

Connections:
/Output Leds/OEnable: C2.2, R2.2; also elsewhere on the board
/Output Leds/Reset: C1.1, R1.1; also elsewhere on the board
GND: C1.2, R2.1, R3.1; also elsewhere on the board
OLEDS_PUSH_DATA: R3.2; also elsewhere on the board
VCC: C2.1, R1.2; also elsewhere on the board

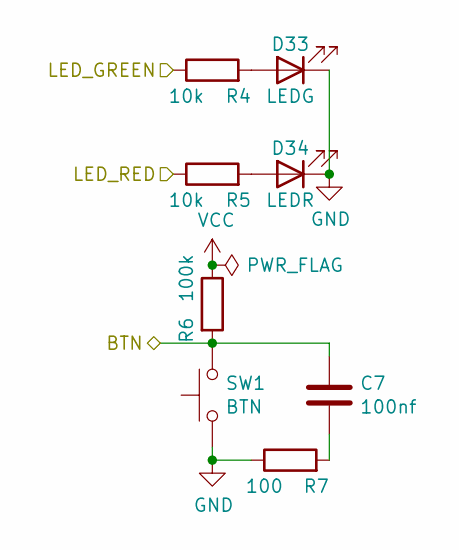
[picture p8: schematic leds_btn.sch]

Parts:
C7: 100nf; C_0402_1005Metric; LCSC Part C83056
D33: LEDG; LED_0805_2012Metric_Castellated; LCSC Part C205442
D34: LEDR; LED_0805_2012Metric_Castellated; LCSC Part C130114
R4, R5: 10k; R_0603_1608Metric; LCSC Part C99198
R6: 100k; R_0603_1608Metric; LCSC Part C177329
R7: 100; R_0603_1608Metric; LCSC Part C86983
SW1: BTN; SW_SPST_EVPBF; LCSC Part C620321

Connections:
BTN: C7.1, R6.2, SW1.2; also elsewhere on the board
GND: D33.1 (K), D34.1 (K), R7.1, SW1.1; also elsewhere on the board
LED_GREEN: R4.1; also elsewhere on the board
LED_RED: R5.1; also elsewhere on the board
unnamed: C7.2, R7.2
unnamed: D33.2 (A), R4.2
unnamed: D34.2 (A), R5.2
VCC: R6.1; also elsewhere on the board

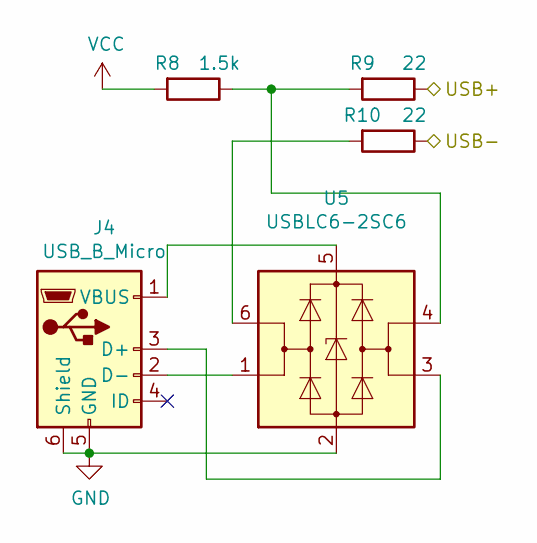
[picture p9: schematic USB.sch]

Parts:
J4: USB_B_Micro; USB_Micro-B_Molex-105133-0001; LCSC Part C168716
R8: 1.5k; R_0603_1608Metric; LCSC Part C25989
R9, R10: 22; R_0603_1608Metric; LCSC Part C96423
U5: USBLC6-2SC6; SOT-23-6; LCSC Part C7519

Connections:
GND: J4.5 (GND), J4.6 (Shield), U5.2 (GND); also elsewhere on the board
unnamed: J4.1 (VBUS), U5.5 (VBUS)
unnamed: J4.2 (D-), U5.1 (I/O1)
unnamed: J4.3 (D+), U5.3 (I/O2)
unnamed: R8.1, R9.2, U5.4 (I/O2)
unnamed: R10.2, U5.6 (I/O1)
USB+: R9.1; also elsewhere on the board
USB-: R10.1; also elsewhere on the board
VCC: R8.2; also elsewhere on the board

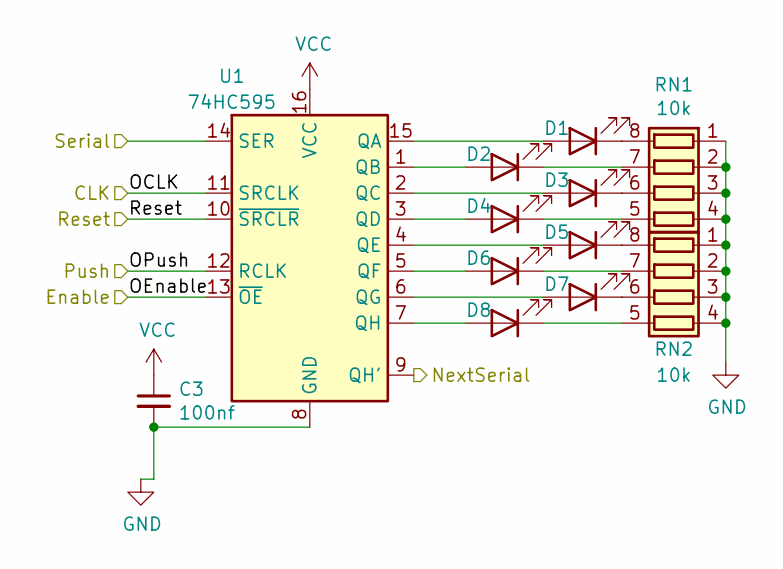
[picture p10: schematic out_leds_8bit.sch]

Parts:
C3: 100nf; C_0402_1005Metric; LCSC Part C83056
D1, D2, D3, D4, D5, D6, D7, D8: LED; LED_0805_2012Metric_Castellated; LCSC Part C205441
RN1, RN2: 10k; R_Array_Convex_4x0603; LCSC Part C164037
U1: 74HC595; SOIC-16_4.55x10.3mm_P1.27mm; LCSC Part C5947

Connections:
/Output Leds/OEnable: U1.13 (~OE); also elsewhere on the board
/Output Leds/ONReg1: U1.14 (SER); also elsewhere on the board
/Output Leds/Reset: U1.10 (~SRCLR); also elsewhere on the board
GND: C3.2, RN1.1 (R1.1), RN1.2 (R2.1), RN1.3 (R3.1), RN1.4 (R4.1), RN2.1 (R1.1), RN2.2 (R2.1), RN2.3 (R3.1), RN2.4 (R4.1), U1.8 (GND); also elsewhere on the board
unnamed: D1.1 (K), RN1.8 (R1.2)
unnamed: D1.2 (A), U1.15 (QA)
unnamed: D2.1 (K), RN1.7 (R2.2)
unnamed: D2.2 (A), U1.1 (QB)
unnamed: D3.1 (K), RN1.6 (R3.2)
unnamed: D3.2 (A), U1.2 (QC)
unnamed: D4.1 (K), RN1.5 (R4.2)
unnamed: D4.2 (A), U1.3 (QD)
unnamed: D5.1 (K), RN2.8 (R1.2)
unnamed: D5.2 (A), U1.4 (QE)
unnamed: D6.1 (K), RN2.7 (R2.2)
unnamed: D6.2 (A), U1.5 (QF)
unnamed: D7.1 (K), RN2.6 (R3.2)
unnamed: D7.2 (A), U1.6 (QG)
unnamed: D8.1 (K), RN2.5 (R4.2)
unnamed: D8.2 (A), U1.7 (QH)
OLEDS_PUSH_DATA: U1.12 (RCLK); also elsewhere on the board
SPICLK: U1.11 (SRCLK); also elsewhere on the board
VCC: C3.1, U1.16 (VCC); also elsewhere on the board

Parts of its further copies:
C4, C5, C6: 100nf; C_0402_1005Metric; LCSC Part C83056
D9, D10, D11, D12, D13, D14, D15, D16, D17, D18, D19, D20, D21, D22, D23, D24, D25, D26, D27, D28, D29, D30, D31, D32: LED; LED_0805_2012Metric_Castellated; LCSC Part C205441
RN3, RN4, RN5, RN6, RN7, RN8: 10k; R_Array_Convex_4x0603; LCSC Part C164037
U2, U3, U4: 74HC595; SOIC-16_4.55x10.3mm_P1.27mm; LCSC Part C5947

Connections of its further copies:
/Output Leds/OEnable: U2.13 (~OE), U3.13 (~OE), U4.13 (~OE); also elsewhere on the board
/Output Leds/ONReg1: U2.9 (QH'); also elsewhere on the board
/Output Leds/ONReg2: U2.14 (SER), U3.9 (QH')
/Output Leds/ONReg3: U3.14 (SER), U4.9 (QH')
/Output Leds/Reset: U2.10 (~SRCLR), U3.10 (~SRCLR), U4.10 (~SRCLR); also elsewhere on the board
GND: C4.2, C5.2, C6.2, RN3.1 (R1.1), RN3.2 (R2.1), RN3.3 (R3.1), RN3.4 (R4.1), RN4.1 (R1.1), RN4.2 (R2.1), RN4.3 (R3.1), RN4.4 (R4.1), RN5.1 (R1.1), RN5.2 (R2.1), RN5.3 (R3.1), RN5.4 (R4.1), RN6.1 (R1.1), RN6.2 (R2.1), RN6.3 (R3.1), RN6.4 (R4.1), RN7.1 (R1.1), RN7.2 (R2.1), RN7.3 (R3.1), RN7.4 (R4.1), RN8.1 (R1.1), RN8.2 (R2.1), RN8.3 (R3.1), RN8.4 (R4.1), U2.8 (GND), U3.8 (GND), U4.8 (GND); also elsewhere on the board
unnamed: D9.1 (K), RN3.8 (R1.2)
unnamed: D9.2 (A), U2.15 (QA)
unnamed: D10.1 (K), RN3.7 (R2.2)
unnamed: D10.2 (A), U2.1 (QB)
unnamed: D11.1 (K), RN3.6 (R3.2)
unnamed: D11.2 (A), U2.2 (QC)
unnamed: D12.1 (K), RN3.5 (R4.2)
unnamed: D12.2 (A), U2.3 (QD)
unnamed: D13.1 (K), RN4.8 (R1.2)
unnamed: D13.2 (A), U2.4 (QE)
unnamed: D14.1 (K), RN4.7 (R2.2)
unnamed: D14.2 (A), U2.5 (QF)
unnamed: D15.1 (K), RN4.6 (R3.2)
unnamed: D15.2 (A), U2.6 (QG)
unnamed: D16.1 (K), RN4.5 (R4.2)
unnamed: D16.2 (A), U2.7 (QH)
unnamed: D17.1 (K), RN5.8 (R1.2)
unnamed: D17.2 (A), U3.15 (QA)
unnamed: D18.1 (K), RN5.7 (R2.2)
unnamed: D18.2 (A), U3.1 (QB)
unnamed: D19.1 (K), RN5.6 (R3.2)
unnamed: D19.2 (A), U3.2 (QC)
unnamed: D20.1 (K), RN5.5 (R4.2)
unnamed: D20.2 (A), U3.3 (QD)
unnamed: D21.1 (K), RN6.8 (R1.2)
unnamed: D21.2 (A), U3.4 (QE)
unnamed: D22.1 (K), RN6.7 (R2.2)
unnamed: D22.2 (A), U3.5 (QF)
unnamed: D23.1 (K), RN6.6 (R3.2)
unnamed: D23.2 (A), U3.6 (QG)
unnamed: D24.1 (K), RN6.5 (R4.2)
unnamed: D24.2 (A), U3.7 (QH)
unnamed: D25.1 (K), RN7.8 (R1.2)
unnamed: D25.2 (A), U4.15 (QA)
unnamed: D26.1 (K), RN7.7 (R2.2)
unnamed: D26.2 (A), U4.1 (QB)
unnamed: D27.1 (K), RN7.6 (R3.2)
unnamed: D27.2 (A), U4.2 (QC)
unnamed: D28.1 (K), RN7.5 (R4.2)
unnamed: D28.2 (A), U4.3 (QD)
unnamed: D29.1 (K), RN8.8 (R1.2)
unnamed: D29.2 (A), U4.4 (QE)
unnamed: D30.1 (K), RN8.7 (R2.2)
unnamed: D30.2 (A), U4.5 (QF)
unnamed: D31.1 (K), RN8.6 (R3.2)
unnamed: D31.2 (A), U4.6 (QG)
unnamed: D32.1 (K), RN8.5 (R4.2)
unnamed: D32.2 (A), U4.7 (QH)
OLEDS_PUSH_DATA: U2.12 (RCLK), U3.12 (RCLK), U4.12 (RCLK); also elsewhere on the board
SPICLK: U2.11 (SRCLK), U3.11 (SRCLK), U4.11 (SRCLK); also elsewhere on the board
SPIMOSI: U4.14 (SER); also elsewhere on the board
VCC: C4.1, C5.1, C6.1, U2.16 (VCC), U3.16 (VCC), U4.16 (VCC); also elsewhere on the board

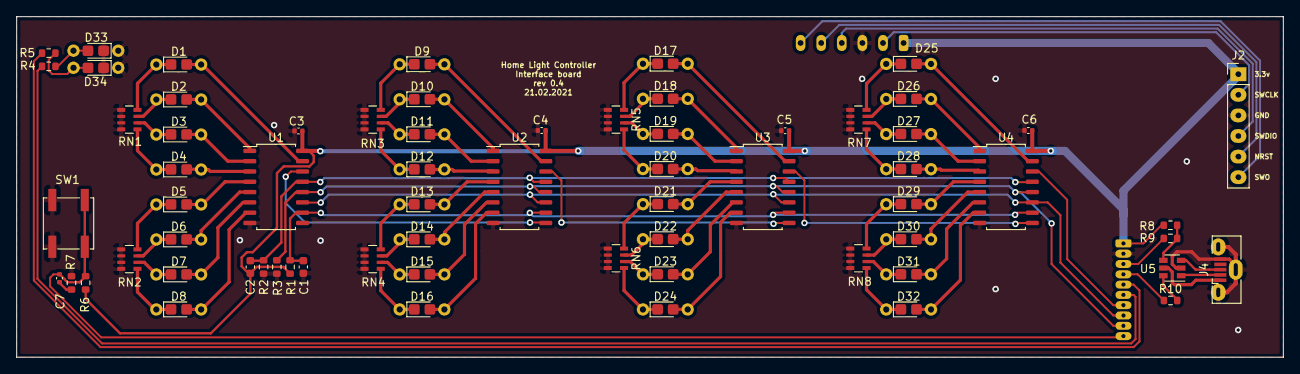
[picture p11: board interface_board.kicad_pcb from above]

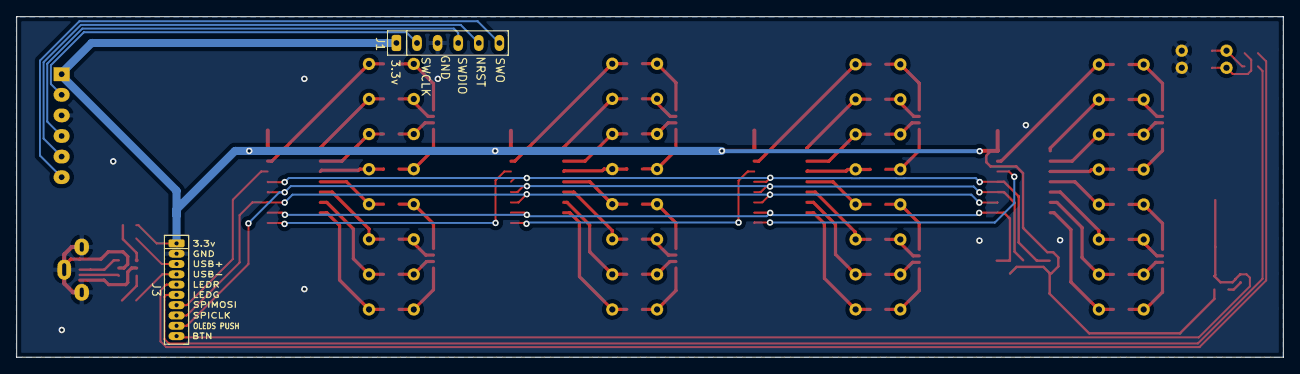
[picture p12: board interface_board.kicad_pcb from below]

Board: 2 copper layers, 156.2 x 42.0 mm, 69 parts (2 on the bottom side), 91 nets.
