sokolovmy/HLC/Core/Inc/main.h

#define PIN_EEPROM_SELECT_Pin GPIO_PIN_4
#define PIN_EEPROM_SELECT_GPIO_Port GPIOA
#define PIN_OUT_PUSH_DATA_Pin GPIO_PIN_0
#define PIN_OUT_PUSH_DATA_GPIO_Port GPIOB
#define PIN_BTN_Pin GPIO_PIN_11
#define PIN_BTN_GPIO_Port GPIOB
#define PIN_OUT_LED_PUSH_DATA_Pin GPIO_PIN_12
#define PIN_OUT_LED_PUSH_DATA_GPIO_Port GPIOB
#define PIN_IN_LOAD_Pin GPIO_PIN_8
#define PIN_IN_LOAD_GPIO_Port GPIOA
#define PIN_LED_GREEN_Pin GPIO_PIN_9
#define PIN_LED_GREEN_GPIO_Port GPIOA
#define PIN_LED_RED_Pin GPIO_PIN_10
#define PIN_LED_RED_GPIO_Port GPIOA
