sokolovmy/HLC/holse/config.c

#include "config.h"
#include "STM32_EEPROM_SPI.h"
#include "spi.h"
#include "string.h"
#include "config.h"


char signature[] = "S4b8249f1fd7ee005a77bdfbdd2z9108";
struct __attribute__((__packed__)) {
	ConfigInput configInputs[32]; //< btn down
	ConfigInput configInputsClick[32]; //< btn click
	ConfigInput configInputsDoubleClick[32]; //< btn double click
	ConfigInput configInputsLPress[32];
	ConfigTimer configTimers[32];
} config;




void setInput(int input, ConfigOp op, BitPorts out, uint8_t timerN) {
	if (input >= MAX_INPUTS) return;
	config.configInputs[input].op = op;
	config.configInputs[input].out = out;
	config.configInputs[input].timerN = timerN;
};
void setInputClick(int input, ConfigOp op, BitPorts out, uint8_t timerN) {
	if (input >= MAX_INPUTS) return;
	config.configInputsClick[input].op = op;
	config.configInputsClick[input].out = out;
	config.configInputsClick[input].timerN = timerN;
};
void setInputDoubleClick(int input, ConfigOp op, BitPorts out, uint8_t timerN) {
	if (input >= MAX_INPUTS) return;
	config.configInputsDoubleClick[input].op = op;
	config.configInputsDoubleClick[input].out = out;
	config.configInputsDoubleClick[input].timerN = timerN;
};
void setInputLPress(int input, ConfigOp op, BitPorts out, uint8_t timerN) {
	if (input >= MAX_INPUTS) return;
	config.configInputsLPress[input].op = op;
	config.configInputsLPress[input].out = out;
	config.configInputsLPress[input].timerN = timerN;
};

void setConfigTimer(int timer, BitPorts out, uint32_t secs) {
	if (timer >= MAX_TIMERS) return;
	config.configTimers[timer].out = out;
	config.configTimers[timer].secs = secs;
};
ConfigInput * getInput(int input){
	if (input >= MAX_INPUTS) return NULL;
	return &config.configInputs[input];
};
ConfigInput * getInputClick(int input){
	if (input >= MAX_INPUTS) return NULL;
	return &config.configInputsClick[input];
};
ConfigInput * getInputDoubleClick(int input){
	if (input >= MAX_INPUTS) return NULL;
	return &config.configInputsDoubleClick[input];
};
ConfigInput * getInputLPress(int input){
	if (input >= MAX_INPUTS) return NULL;
	return &config.configInputsLPress[input];
};

ConfigTimer * getConfigTimer(int timer){
	if (timer >= MAX_INPUTS) return NULL;
	return &config.configTimers[timer];
};

int loadFromFlash(void) {
	EEPROM_SPI_INIT(&hspi1);
	char buf[sizeof(signature)] = {0};
	EEPROM_SPI_ReadBuffer((uint8_t *)buf, 0, sizeof(signature));
	if (strncmp(signature, buf, sizeof(signature)) == 0) // read from flash config
		EEPROM_SPI_ReadBuffer((uint8_t *)&config, sizeof(signature), sizeof(config));
	else {
		memset(&config, 0, sizeof(config));
		config.configInputsLPress[0].op = off;
		config.configInputsLPress[0].out = -1;//0xFFFF;
		for(int i = 0; i < MAX_INPUTS; i++) {
			config.configInputs[i].op = toggle;
			config.configInputs[i].out = 1 << i;
			//config.configInputsLPress[i].op = off;
			//config.configInputsLPress[i].out = config.configInputs[i].out;
		}
	}
	return 0;
};

int saveToFlash(void) {
	EEPROM_SPI_INIT(&hspi1);
	EepromOperations res = EEPROM_SPI_WriteBuffer((uint8_t *)signature, 0, sizeof(signature));
	if (res != EEPROM_STATUS_COMPLETE) return -1;
	EEPROM_SPI_WriteBuffer((uint8_t *)&config, sizeof(signature), sizeof(config));
	if (res != EEPROM_STATUS_COMPLETE) return -2;
	return 0;
};
