sokolovmy/HLC/holse/leds_walk.h

/*
 * leds_walk.h
 *
 *  Created on: Mar 26, 2022
 *      Author: Maxim Sokolov sokolovmy@gmail.com
 */

#ifndef LEDS_WALK_H_
#define LEDS_WALK_H_


void LedsWalk(int enable_outs);



#endif /* LEDS_WALK_H_ */
